waxnwire/shieldXL/bom/additional details.rtf

norns_shield_211028_octo

Query Qty Manufacturer MPN

311-1343-2-ND 6 Yageo CC0603ZRY5V9BB104

RC0603FR-0710KL 22 Yageo RC0603FR-0710KL
CC0603KRX7R9BB103 14 Yageo CC0603KRX7R9BB103
GRM21BR61E106KA73L 5 Murata GRM21BR61E106KA73L
RC0603FR-071K33L 2 Yageo RC0603FR-071K33L
RC0603FR-071K5L 2 Yageo RC0603FR-071K5L
C0603C152F1GAC7867 2 KEMET C0603C152F1GAC7867
GRM1885C1H222JA01J 2 Murata GRM1885C1H222JA01J
CL31A226MOCLNNC 4 Samsung CL31A226MOCLNNC
GRM1885C1H272JA01D 2 Murata GRM1885C1H272JA01D
RC0603FR-072K32L 2 Yageo RC0603FR-072K32L
CL10C471JB8NFNC 2 Samsung CL10C471JB8NFNC
GMC10CG471J50NTD 2 Cal-Chip Electronics GMC10CG471J50NTD
RC0603FR-0747KL 2 Yageo RC0603FR-0747KL
C3216X5R1E476M160AC 2 TDK C3216X5R1E476M160AC
RC0603FR-074K42L 2 Yageo RC0603FR-074K42L
RC0603FR-074K99L 2 Yageo RC0603FR-074K99L
RC0603FR-07560RL 2 Yageo RC0603FR-07560RL
RC0603FR-07634RL 2 Yageo RC0603FR-07634RL
C0603C682J5GAC7867 2 KEMET C0603C682J5GACTU
RC0603FR-07715RL 2 Yageo RC0603FR-07715RL
RC0603FR-0791RL 2 Yageo RC0603FR-0791RL
ASFL1-12.288MHZ-EC-T 1 Abracon ASFL1-12.288MHZ-EC-T
CS4271-CZZ 1 Cirrus Logic CS4271-CZZ
PEC11R-4015F-N0024 3 Bourns PEC11R-4015F-N0024
BLM21PG331SN1D 1 Murata BLM21PG331SN1D
4832.233 2 Schurter 4832.233
TSW-120-05-T-S 1 Samtec TSW-120-05-T-S
PVA1 OA H1 1.2N V2 3 C&K Components PVA1 OA H1 1.2N V2
1528-1969-ND 1 Adafruit Industries 1992
TSV358AIDT 3 STMicroelectronics TSV358AIDT
TPS793475DBVR 1 Texas Instruments TPS793475DBVR
NHD-2.7-12864WDY3 1 Newhaven Display NHD-2.7-12864WDY3

Page 1
norns_shield_211028_octo
Octopart URL
https://octopart.com/cc0603zry5v9bb104-yageo-4507169
https://octopart.com/rc0603fr-0710kl-yageo-40025538
https://octopart.com/cc0603krx7r9bb103-yageo-192938
https://octopart.com/grm21br61e106ka73l-murata-11231261
https://octopart.com/rc0603fr-071k33l-yageo-1209398
https://octopart.com/rc0603fr-071k5l-yageo-55458478
https://octopart.com/c0603c152f1gac7867-kemet-51214920
https://octopart.com/grm1885c1h222ja01j-murata-16412836
https://octopart.com/cl31a226moclnnc-samsung-19832800
https://octopart.com/grm1885c1h272ja01d-murata-196902
https://octopart.com/rc0603fr-072k32l-yageo-1384316
https://octopart.com/cl10c471jb8nfnc-samsung-19832014
https://octopart.com/gmc10cg471j50ntd-cal-chip+electronics-4681919
https://octopart.com/rc0603fr-0747kl-yageo-1369017
https://octopart.com/c3216x5r1e476m160ac-tdk-25947783
https://octopart.com/rc0603fr-074k42l-yageo-39829078
https://octopart.com/rc0603fr-074k99l-yageo-55458490
https://octopart.com/rc0603fr-07560rl-yageo-1265587
https://octopart.com/rc0603fr-07634rl-yageo-1213507
https://octopart.com/c0603c682j5gactu-kemet-12793182
https://octopart.com/rc0603fr-07715rl-yageo-1167489
https://octopart.com/rc0603fr-0791rl-yageo-1235547
https://octopart.com/asfl1-12.288mhz-ec-t-abracon-317620
https://octopart.com/cs4271-czz-cirrus+logic-428039
https://octopart.com/pec11r-4015f-n0024-bourns-26648251
https://octopart.com/blm21pg331sn1d-murata-755248
https://octopart.com/4832.2330-schurter-6626217
https://octopart.com/tsw-120-05-t-s-samtec-271715
https://octopart.com/pva1+oa+h1+1.2n+v2-c%26k+components-319302
https://octopart.com/1992-adafruit+industries-53880115
https://octopart.com/tsv358aidt-stmicroelectronics-1245014
https://octopart.com/tps793475dbvr-texas+instruments-525242
https://octopart.com/nhd-2.7-12864wdy3-newhaven+display-84706410
Page 2
norns_shield_211028_octo
Part Description
0603 0.1 uF 50 V -20 / +80 % Tolerance Y5V SMT Multilayer Ceramic Capacitor
Res General Purpose Thick Film 0603 10K Ohm 1% 1/10W ±100ppm/°C Molded SMD Paper T/R
SMD Multilayer Ceramic Capacitor, 10000 pF, 50 V, 0603 [1608 Metric], ± 10%, X7R, CC Series
0805 10 uF 25 V ±10% Tolerance X5R SMT Multilayer Ceramic Capacitor
Res Thick Film 0603 1.33K Ohm 1% 0.1W(1/10W) ±100ppm/C Pad SMD T/R
Res General Purpose Thick Film 0603 1.5K Ohm 1% 1/10W ±100ppm/°C Molded SMD Paper T/
Cap Ceramic 0.0015uF 100V C0G 1% SMD 0603 125°C Punched Paper T/R
0603 50 V 2200 pF ±5% Tolerance C0G Multilayer Ceramic Capacitor
Cap Ceramic 22uF 16V X5R 20% SMD 1206 85°C Cardboard T/R
0603 2.7 nF 50 V ±5 % Tolerance C0G SMT Multilayer Ceramic Capacitor
Res Thick Film 0603 2.32K Ohm 1% 0.1W(1/10W) ±100ppm/C Pad SMD T/R
Cap Ceramic 470pF 50V C0G 5% SMD 0603 125°C Paper T/R
Cap Cer 470PF 50V C0G/NP0 0603
Res Thick Film 0603 47K Ohm 1% 1/10W ±100ppm/°C Molded SMD Paper T/R
C Series 1206 47 uF 25 V ±20 % Tolerance X5R SMT Multilayer Ceramic Capacitor
Res Thick Film 1.6 x 0.8 mm 4.42K Ohm 1% 0.1W(1/10W) 100ppm/ C Molded SMD Paper T/R
Res General Purpose Thick Film 0603 4.99k Ohm 1% 1/10W ±100ppm/°C Molded Paper T/R
Res Thick Film 0603 560 Ohm 1% 0.1W(1/10W) ±100ppm/C Pad SMD T/R
Res Thick Film 0603 634 Ohm 1% 0.1W(1/10W) ±100ppm/C Pad SMD T/R
0603 C 6.8nF Ceramic Multilayer Capacitor; 50 V; +125degC; C0G Dielectric; +/-5%
Res Thick Film 0603 715 Ohm 1% 0.1W(1/10W) ±100ppm/°C Pad SMD T/R
Res Thick Film 0603 91 Ohm 1% 0.1W(1/10W) ±100ppm/°C Pad SMD T/R
Oscillator XO 12.288MHz 50ppm 15pF (Stability) HCMOS/TTL 60% 3.3V 4-Pin SMD T/R
Audio Codec 2ADC / 2DAC 24-Bit 28-Pin TSSOP Tube
24 Pulse Incremental Mechanical Rotary Encoder w/ 6 mm Flat Shaft; Through Hole
Ferrite Beads Multi-Layer 330Ohm 25% 100MHz 1.5A 70mOhm DCR 0805 Automotive Paper T/
Conn 3.5MM Audio Jack SKT 4 POS Solder RA Thru-Hole 4 Terminal 1 Port
Headers & Wire Housings Classic PCB Header Strips, 0.100 pitch
Switch Push Button DPST Square Button 0.1A 32VDC Momentary Contact PC Pins Thru-Hole
GPIO Header for Raspberry Pi A+/B+ - Tall 2x20 Female Header
General purpose low voltage rail to rail input/output op-amp, -40 to 125°C, SO-8, Tape and Reel
Ldo Voltage Regulator, 4.75V, 0.2A, 5-SOT-23, Full Reel
OLED Displays & Accessories 2.7 in Yellow OLED 128 x 64
Page 3
norns_shield_211028_octo
Description
100n
10k
10n
10u
1k33
1k5
1n5
2200p COG
22u
2700p COG
2k32
470p
470p COG
47k
47u
4k42
4k99
560
634
6n8
715
91
ASFL-12.288mhz
CS4271
ENC
FERRITE
JACK-TRS-SW
OLED128X64
PVA1
RASPI_BOARD_B+#_E3
TL072D
TPS793
Page 4
norns_shield_211028_octo
Schematic Reference

C1, C6, C8, C18, C47, C63

R1, R2, R3, R4, R8, R9, R15, R26, R28, R29, R32, R34, R35, R38, R40, R41, R44, R45, R46, R47, R48, R49
C3, C14, C16, C20, C35, C36, C38, C39, C41, C42, C44, C45, C46, C88
C2, C5, C10, C19, C43
R11, R19
R13, R21
C22, C28
C15, C25
C21, C24, C27, C30
C4, C13
R16, R23
C23, C29
C11, C12
R18, R25
C7, C9
R12, R20
R17, R24
R27, R30
R5, R10
C17, C26
R14, R22
R6, R7
Q1
U1
E1, E2, E3
L3
J-IN, J-OUT
U$1
SW1, SW2, SW3
X1
IC1, IC2, IC4
U11

Page 5
