waxnwire/shieldXL/Printing/XL_Back.pdf

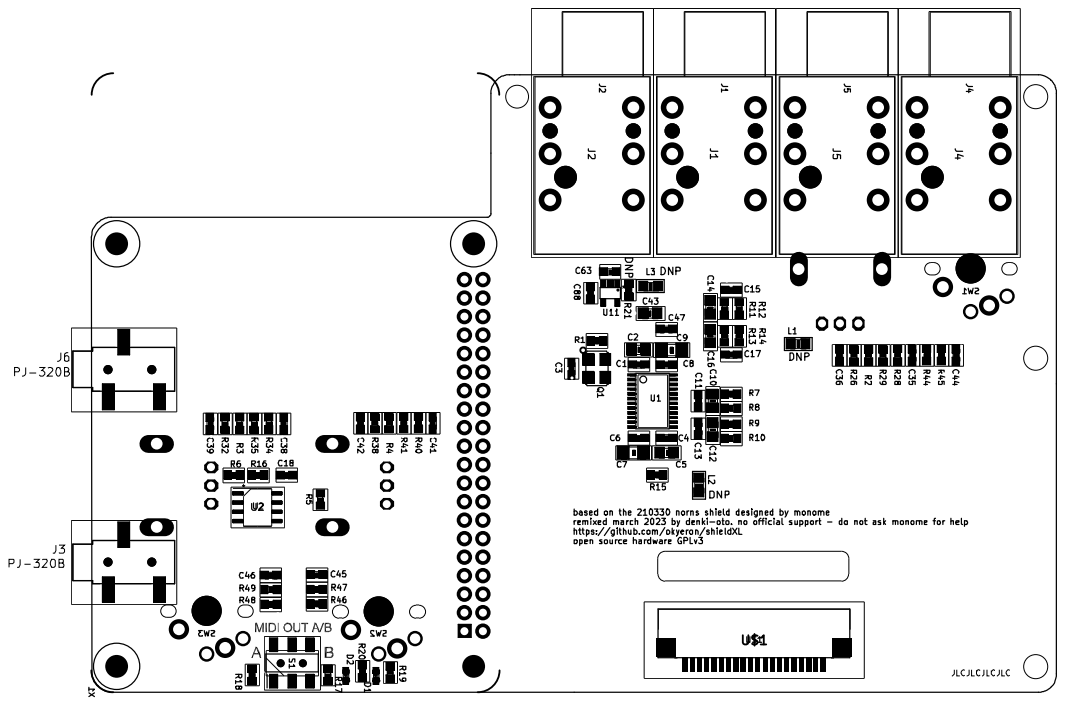
[picture p4: page 1]
