waxnwire/shieldXL/kicad/ShieldXL-M-20230615/ShieldXL-M.kicad_pcb

## KiCad design kicad/ShieldXL-M-20230615/ShieldXL-M.kicad_pcb (2026-01-29)

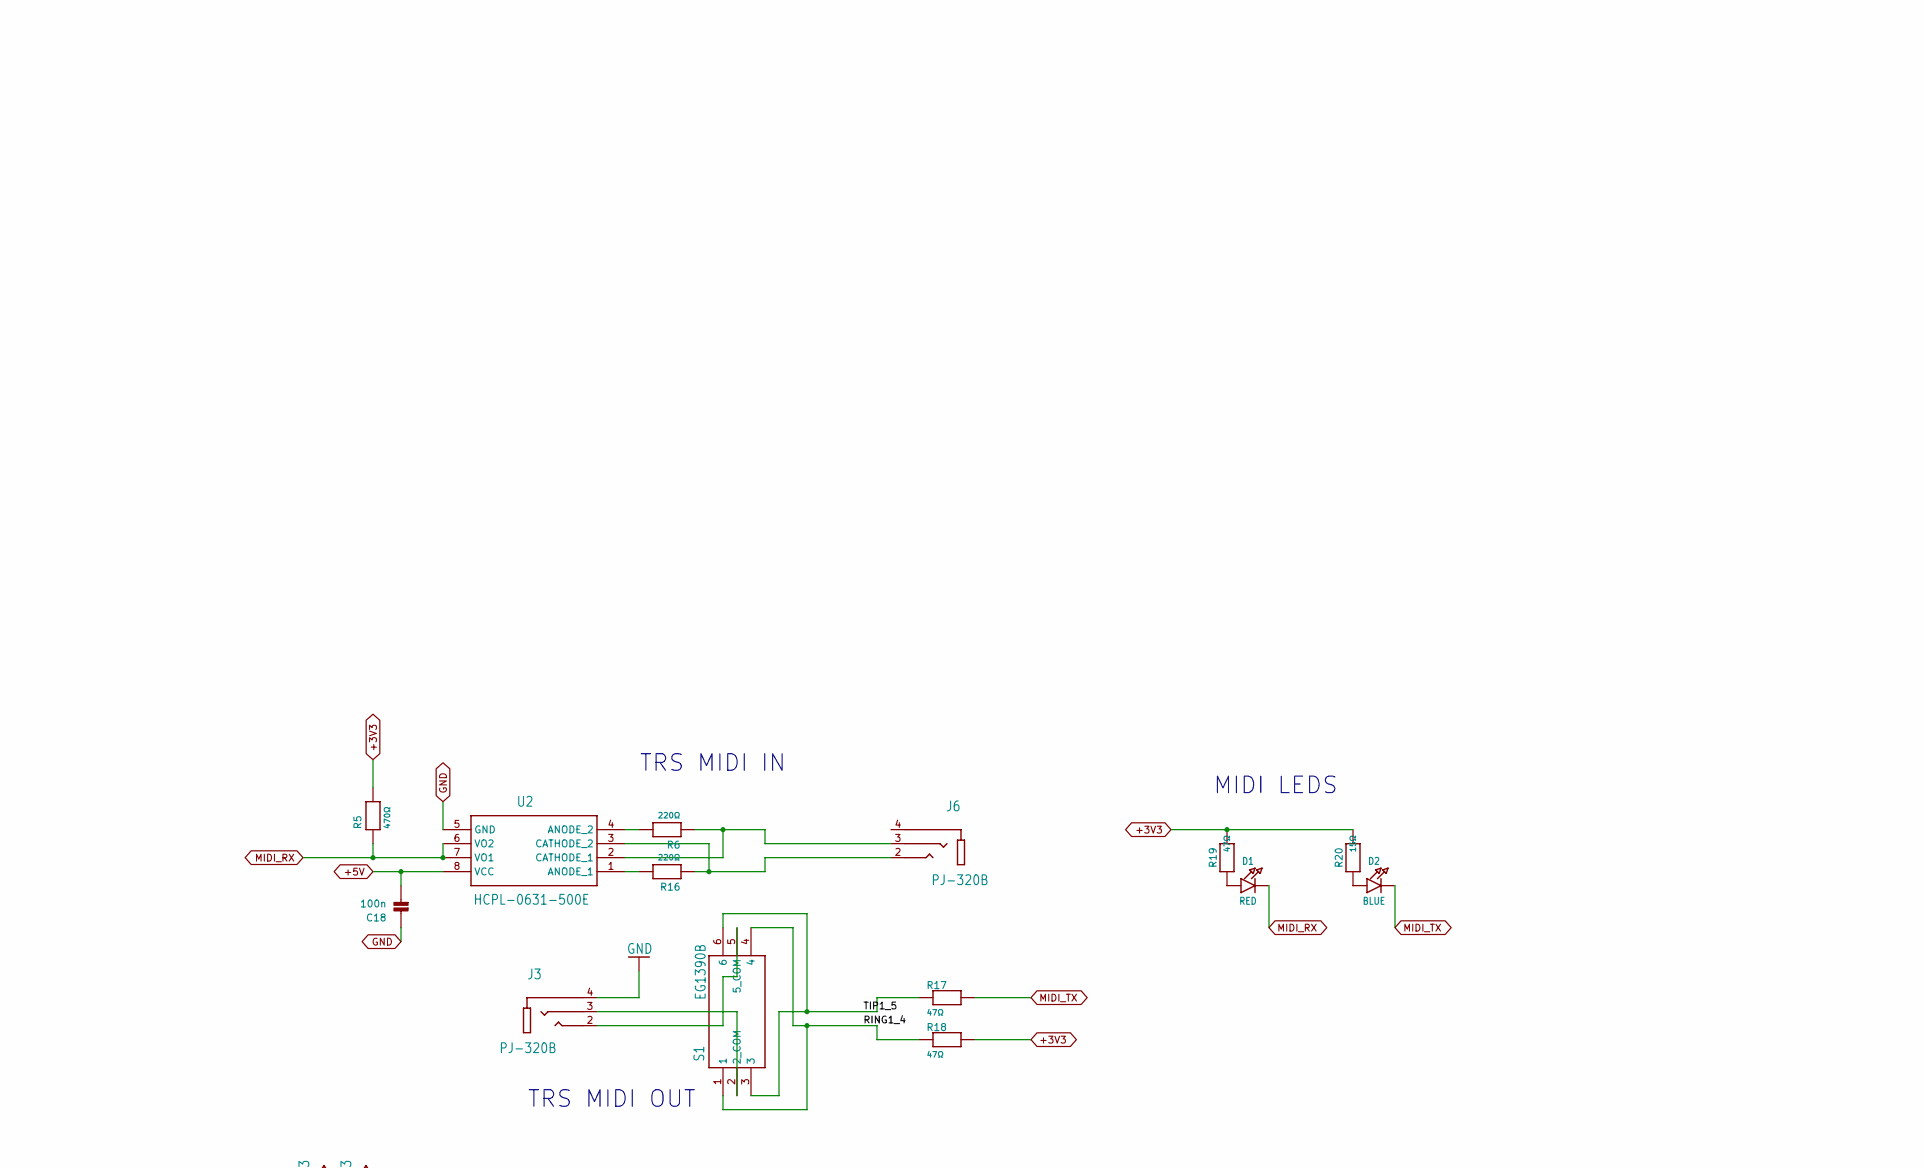
[picture p5: schematic norns-shield-210330_2.kicad_sch, part in row 1, column 2]

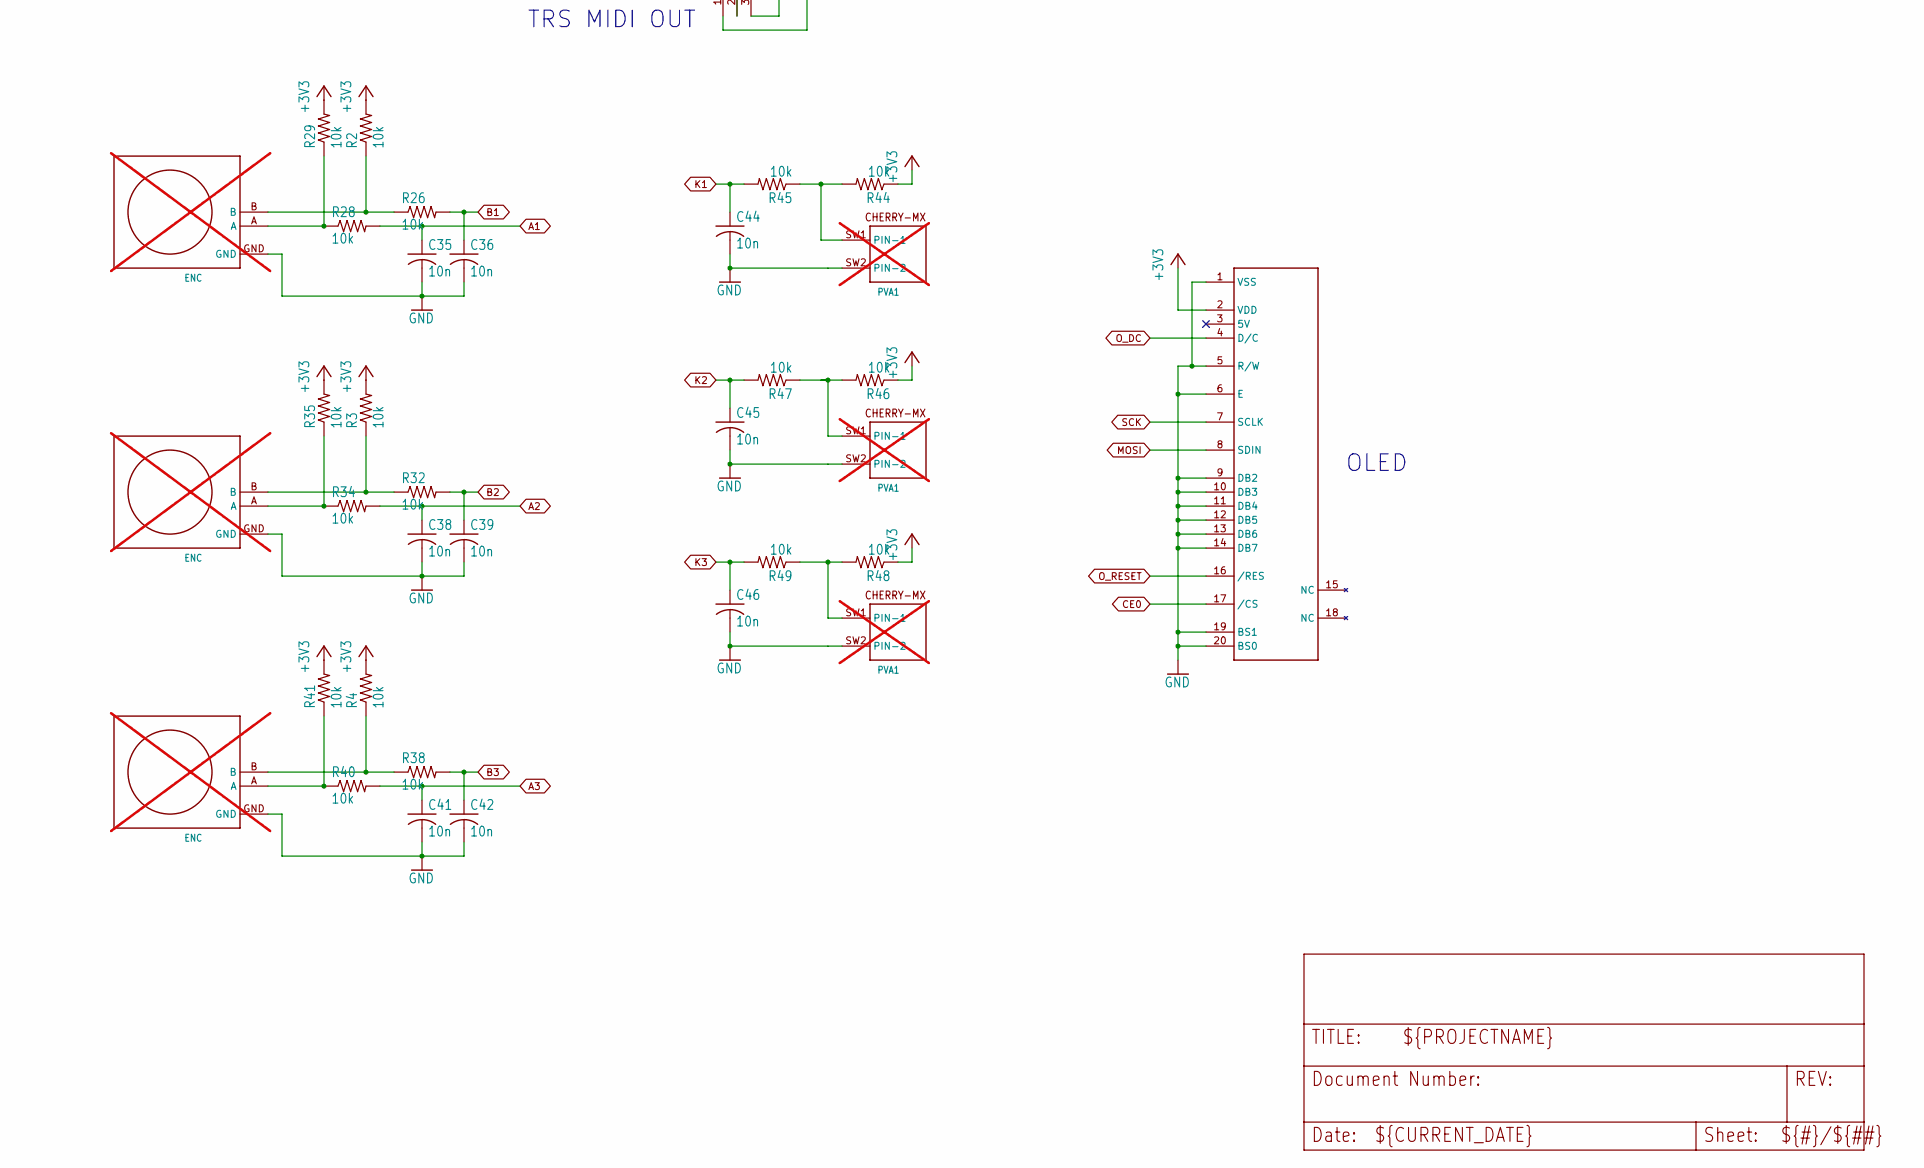
[picture p6: schematic norns-shield-210330_2.kicad_sch, part in row 2, column 2]

Parts:
C18: 100n; C0603
C35, C36, C38, C39, C41, C42, C44, C45, C46: 10n; C0603
D1: RED; CHIPLED_0603_NOOUTLINE
D2: BLUE; CHIPLED_0603_NOOUTLINE
E1, E2, E3: ENC; PEC11RN; not fitted
J3, J6: PJ-320B; LUOYANG-DISHANG_PJ-320B
R2, R3, R4, R26, R28, R29, R32, R34, R35, R38, R40, R41, R44, R45, R46, R47, R48, R49: 10k; R0603
R5: 470Ω; R0603
R6, R16: 220Ω; R0603
R17, R18, R19: 47Ω; R0603
R20: 15Ω; R0603
S1: EG1390B; SOP250P600X400-6N
SW1, SW2, SW3: PVA1; Choc_MX_combo; not fitted
U2: HCPL-0631-500E; SSOP-8_3.9x5.05mm_P1.27mm
U$1: FPC1M20P-B310; F-FPC1M20P-B310

Connections:
+3V3: R2.2, R3.2, R4.2, R5.2, R18.2, R19.2, R20.2, R29.2, R35.2, R41.2, R44.1, R46.1, R48.1, U$1.2 (VDD); also elsewhere on the board
+5V: C18.2, U2.8 (VCC); also elsewhere on the board
/norns-shield-210330_2/RING1_4: R18.1, S1.1, S1.4
/norns-shield-210330_2/TIP1_5: R17.1, S1.3, S1.6
A1: C35.1, R28.2; also elsewhere on the board
A2: C38.1, R34.2; also elsewhere on the board
A3: C41.1, R40.2; also elsewhere on the board
B1: C36.1, R26.2; also elsewhere on the board
B2: C39.1, R32.2; also elsewhere on the board
B3: C42.1, R38.2; also elsewhere on the board
CE0: U$1.17 (/CS); also elsewhere on the board
GND: C18.1, C35.2, C36.2, C38.2, C39.2, C41.2, C42.2, C44.2, C45.2, C46.2, E1.GND, E2.GND, E3.GND, J3.4 (SLEEVE), SW1.SW2 (PIN-2), SW2.SW2 (PIN-2), SW3.SW2 (PIN-2), U2.5 (GND), U$1.1 (VSS), U$1.5 (R/W), U$1.6 (E), U$1.9 (DB2), U$1.10 (DB3), U$1.11 (DB4), U$1.12 (DB5), U$1.13 (DB6), U$1.14 (DB7), U$1.19 (BS1), U$1.20 (BS0); also elsewhere on the board
K1: C44.1, R45.2; also elsewhere on the board
K2: C45.1, R47.2; also elsewhere on the board
K3: C46.1, R49.2; also elsewhere on the board
MIDI_RX: D1.C, R5.1, U2.6 (VO2), U2.7 (VO1); also elsewhere on the board
MIDI_TX: D2.C, R17.2; also elsewhere on the board
MOSI: U$1.8 (SDIN); also elsewhere on the board
unnamed: D1.A, R19.1
unnamed: D2.A, R20.1
unnamed: E1.A, R28.1, R29.1
unnamed: E1.B, R2.1, R26.1
unnamed: E2.A, R34.1, R35.1
unnamed: E2.B, R3.1, R32.1
unnamed: E3.A, R40.1, R41.1
unnamed: E3.B, R4.1, R38.1
unnamed: J3.3 (RING), S1.2 (2_COM)
unnamed: J3.2 (TIP), S1.5 (5_COM)
unnamed: J6.3 (RING), R6.1, U2.2 (CATHODE_1)
unnamed: J6.2 (TIP), R16.1, U2.3 (CATHODE_2)
unnamed: R44.2, R45.1, SW1.SW1 (PIN-1)
unnamed: R46.2, R47.1, SW2.SW1 (PIN-1)
unnamed: R48.2, R49.1, SW3.SW1 (PIN-1)
unnamed: R16.2, U2.1 (ANODE_1)
unnamed: R6.2, U2.4 (ANODE_2)
O_DC: U$1.4 (D/C); also elsewhere on the board
O_RESET: U$1.16 (/RES); also elsewhere on the board
SCK: U$1.7 (SCLK); also elsewhere on the board

Notes on the sheet:
TRS MIDI OUT
OLED
MIDI LEDS
TRS MIDI IN

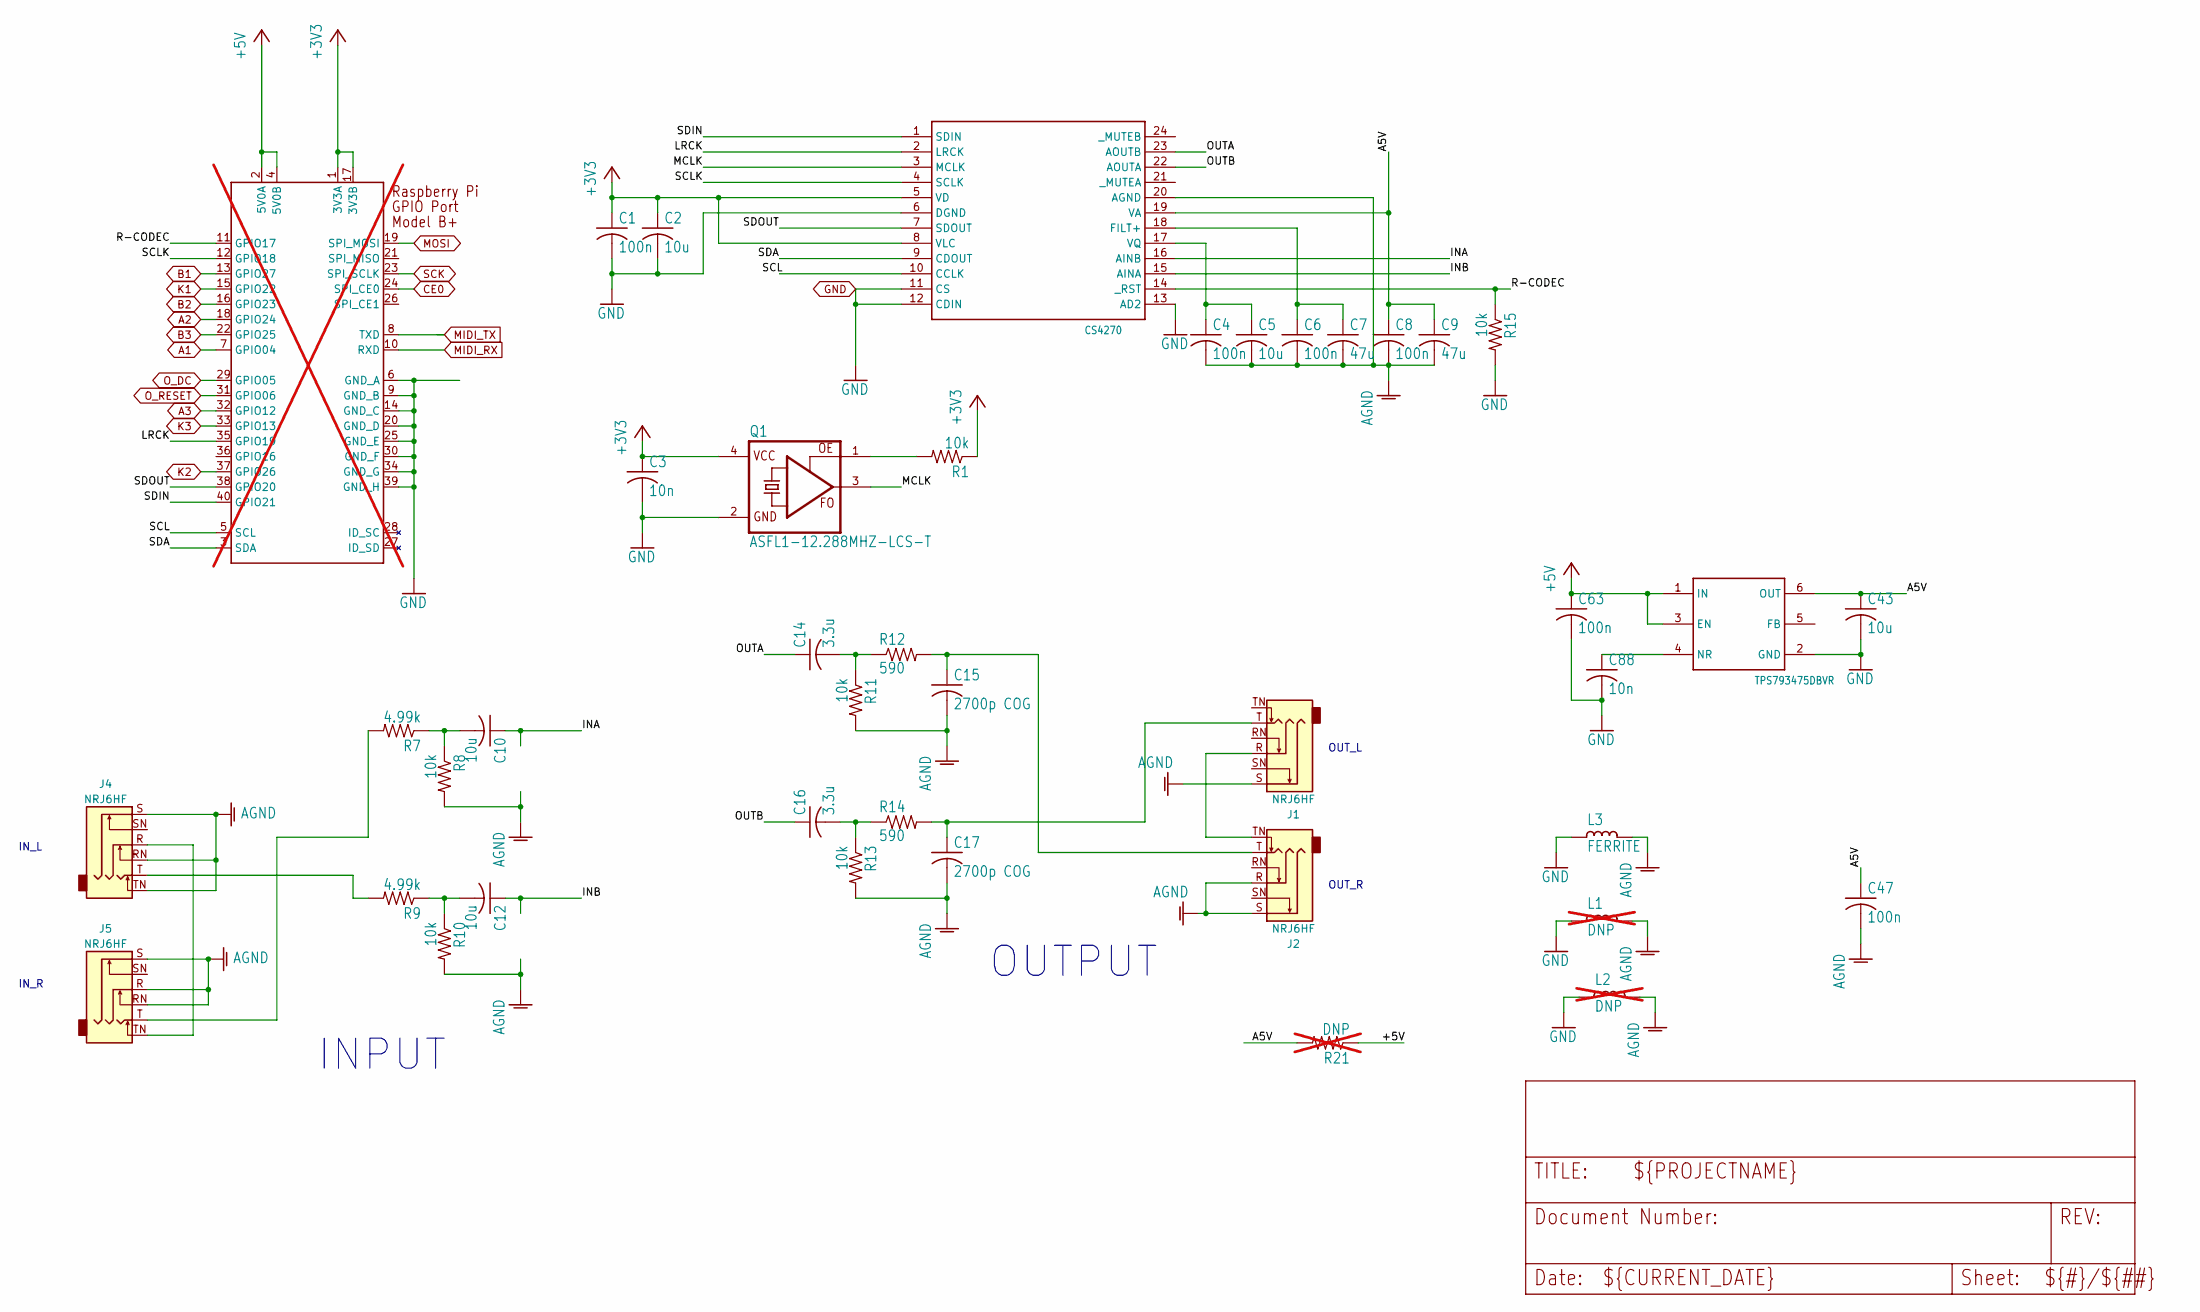
[picture p7: schematic norns-shield-210330_1.kicad_sch]

Parts:
C1, C4, C6, C8, C47, C63: 100n; C0603
C2, C5, C10, C12, C43: 10u; C0805
C3, C88: 10n; C0603
C7, C9: 47u; C1206
C14, C16: 3.3u; C0805
C15, C17: 2700p COG; C0603
J1, J2, J4, J5: NRJ6HF; Jack_6.35mm_Neutrik_NRJ6HF_Horizontal
L1, L2: DNP; L0805; not fitted
L3: FERRITE; L0805
Q1: ASFL1-12.288MHZ-LCS-T; ASF
R1, R8, R10, R11, R13, R15: 10k; R0603
R7, R9: 4.99k; R0603
R12, R14: 590; R0603
R21: DNP; R0603; not fitted
U1: CS4270; TSSOP24
U11: TPS793475DBVR; SSOP5
X1: RASPI_BOARD_B+#_E3; RASPI_BOARD_B+_EDGES_3DRILL; not fitted

Connections:
+3V3: C1.1, C2.1, C3.1, Q1.4 (VCC), R1.1, U1.5 (VD), U1.8 (VLC), X1.1 (3V3A), X1.17 (3V3B); also elsewhere on the board
+5V: C63.1, R21.1, U11.1 (IN), U11.3 (EN), X1.2 (5V0A), X1.4 (5V0B); also elsewhere on the board
/norns-shield-210330_1/A5V: C8.1, C9.1, C43.1, C47.1, R21.2, U1.19 (VA), U11.6 (OUT)
/norns-shield-210330_1/INA: C10.1, U1.16 (AINB); also elsewhere on the board
/norns-shield-210330_1/INB: C12.1, U1.15 (AINA); also elsewhere on the board
/norns-shield-210330_1/LRCK: U1.2 (LRCK), X1.35 (GPIO19)
/norns-shield-210330_1/MCLK: Q1.3 (FO), U1.3 (MCLK)
/norns-shield-210330_1/OUTA: C14.1, U1.23 (AOUTB)
/norns-shield-210330_1/OUTB: C16.1, U1.22 (AOUTA)
/norns-shield-210330_1/R-CODEC: R15.1, U1.14 (_RST), X1.11 (GPIO17)
/norns-shield-210330_1/SCL: U1.10 (CCLK), X1.5 (SCL)
/norns-shield-210330_1/SCLK: U1.4 (SCLK), X1.12 (GPIO18)
/norns-shield-210330_1/SDA: U1.9 (CDOUT), X1.3 (SDA)
/norns-shield-210330_1/SDIN: U1.1 (SDIN), X1.40 (GPIO21)
/norns-shield-210330_1/SDOUT: U1.7 (SDOUT), X1.38 (GPIO20)
A1: X1.7 (GPIO04); also elsewhere on the board
A2: X1.18 (GPIO24); also elsewhere on the board
A3: X1.32 (GPIO12); also elsewhere on the board
AGND: C4.2, C5.2, C6.2, C7.2, C8.2, C9.2, C15.2, C17.2, C47.2, J1.S, J2.R, J2.S, J4.RN, J4.S, J4.TN, J5.R, J5.RN, J5.S, L1.1, L2.1, L3.1, R8.2, R10.2, R11.2, R13.2, U1.20 (AGND); also elsewhere on the board
B1: X1.13 (GPIO27); also elsewhere on the board
B2: X1.16 (GPIO23); also elsewhere on the board
B3: X1.22 (GPIO25); also elsewhere on the board
CE0: X1.24 (SPI_CE0); also elsewhere on the board
GND: C1.2, C2.2, C3.2, C43.2, C63.2, C88.2, L1.2, L2.2, L3.2, Q1.2 (GND), R15.2, U1.6 (DGND), U1.11 (CS), U1.12 (CDIN), U1.13 (AD2), U11.2 (GND), X1.6 (GND_A), X1.9 (GND_B), X1.14 (GND_C), X1.20 (GND_D), X1.25 (GND_E), X1.30 (GND_F), X1.34 (GND_G), X1.39 (GND_H); also elsewhere on the board
K1: X1.15 (GPIO22); also elsewhere on the board
K2: X1.37 (GPIO26); also elsewhere on the board
K3: X1.33 (GPIO13); also elsewhere on the board
MIDI_RX: X1.10 (RXD); also elsewhere on the board
MIDI_TX: X1.8 (TXD); also elsewhere on the board
MOSI: X1.19 (SPI_MOSI); also elsewhere on the board
unnamed: C10.2, R7.1, R8.1
unnamed: C12.2, R9.1, R10.1
unnamed: C14.2, R11.1, R12.1
unnamed: C15.1, J2.T, R12.2
unnamed: C16.2, R13.1, R14.1
unnamed: C17.1, J1.T, R14.2
unnamed: J1.R, J2.TN
unnamed: J4.R, J5.TN
unnamed: J4.T, R9.2
unnamed: J5.T, R7.2
unnamed: Q1.1 (OE), R1.2
unnamed: C6.1, C7.1, U1.18 (FILT+)
unnamed: C4.1, C5.1, U1.17 (VQ)
unnamed: C88.1, U11.4 (NR)
O_DC: X1.29 (GPIO05); also elsewhere on the board
O_RESET: X1.31 (GPIO06); also elsewhere on the board
SCK: X1.23 (SPI_SCLK); also elsewhere on the board

Notes on the sheet:
OUTPUT
IN_R
INPUT
OUT_L
IN_L
OUT_R

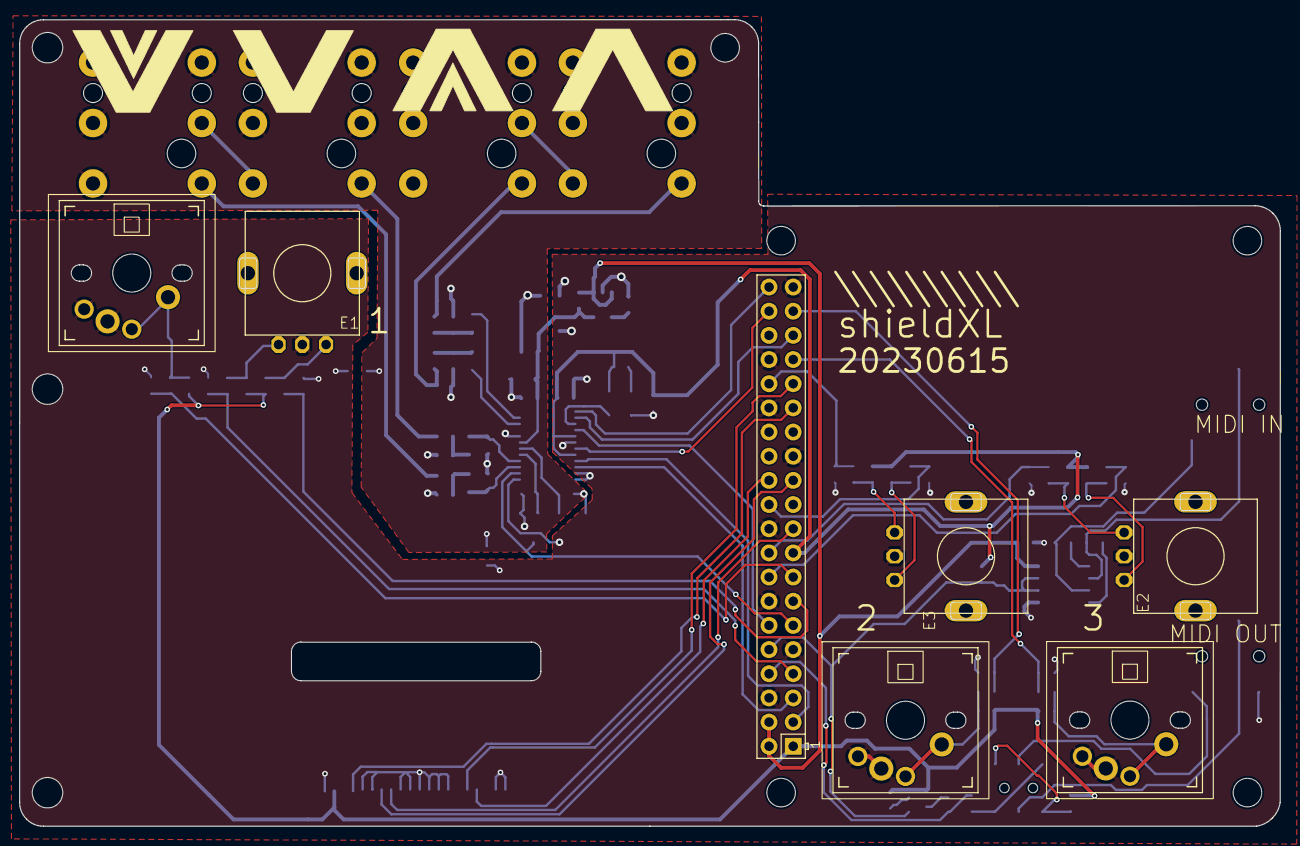
[picture p8: board ShieldXL-M.kicad_pcb from above]

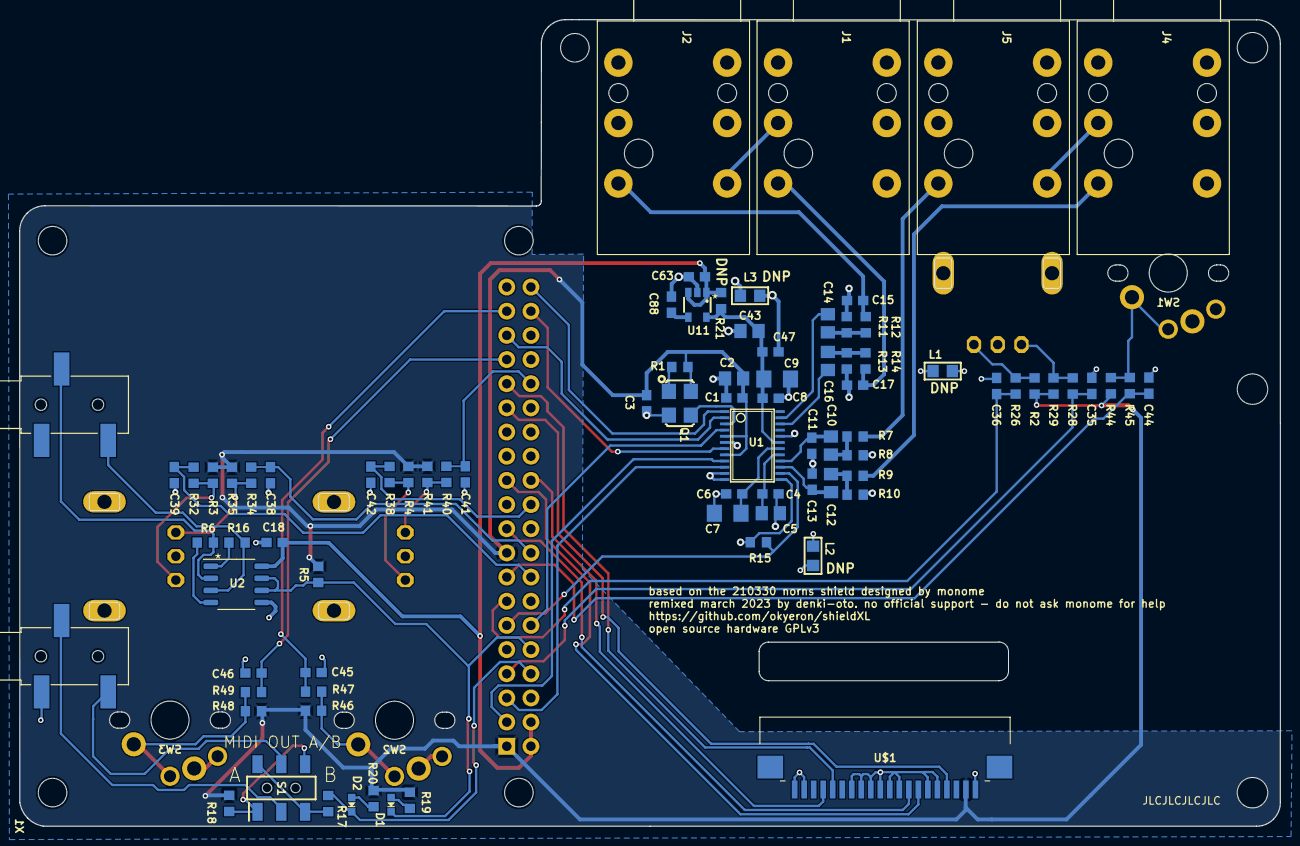
[picture p9: board ShieldXL-M.kicad_pcb from below]

Board: 2 copper layers, 132.5 x 84.8 mm, 91 parts (84 on the bottom side), 66 nets.

Other parts of the board:
C11, C13: 220p COG; C0603

Their connections:
/norns-shield-210330_1/INA: C11.1; also elsewhere on the board
/norns-shield-210330_1/INB: C13.1; also elsewhere on the board
AGND: C11.2, C13.2; also elsewhere on the board
