waxnwire/shieldXL/(commit log)

2025-11-25 updating JLCPCB codes
    [BOM-ShieldXL-M.csv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]
2025-11-30 created a gerber file
    [BOM-ShieldXL-M.csv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]
2025-12-07 updated gerber
    [BOM-ShieldXL-M.csv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]
2026-01-29 fixed gerbers and added printing
    [BOM-ShieldXL-M.csv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]
