waxnwire/shieldXL/(notices)

Notices in the files:
kicad/ShieldXL-M-20230615/ShieldXL-M.kicad_pcb:
open source hardware GPLv3
